L71/ADSR1/README.md

ADSR1
=====

Eurorack digitally controlled ADSR envelope generator.

*** Deprecated (for now at least). 
It works more or less as intended on a breadboard but it got replaced by the ADSR2 module which does more or less the same things but with no MCU.
