L71/ADSR1/PCB/ADSR1.brd

## EAGLE design PCB/ADSR1.brd (2015-07-12)

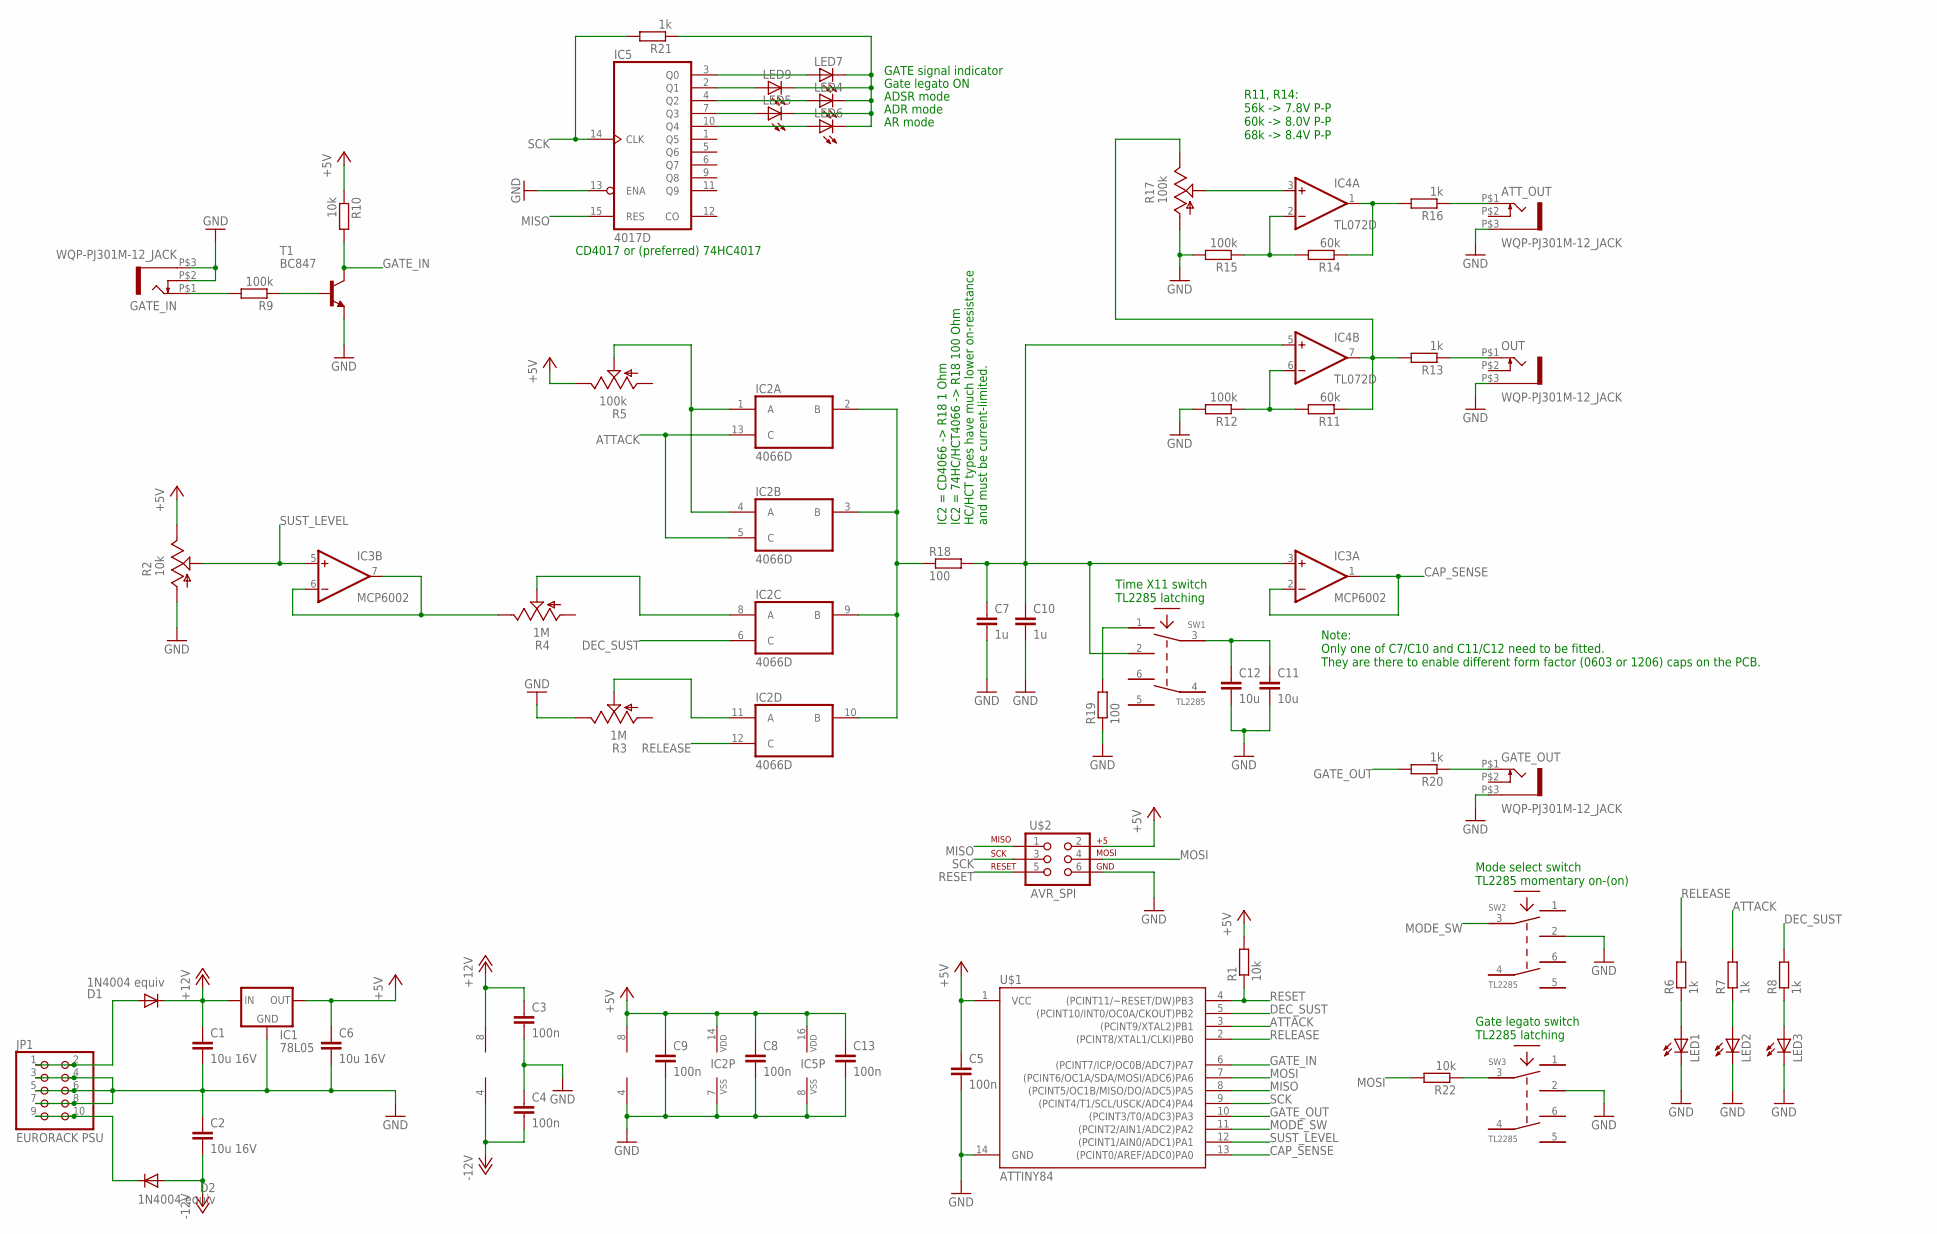
[picture p1: schematic ADSR1.sch]

Parts:
ATT_OUT: WQP-PJ301M-12_JACK
C1, C2, C6: 10u 16V; C1206K
C3, C4, C5, C8, C9, C13: 100n; C0603K
C7: 1u; C0603K
C10: 1u; C1206K
C11: 10u; C1206K
C12: 10u; C0603K
D1, D2: 1N4004 equiv; DO214AA
GATE_IN: WQP-PJ301M-12_JACK
GATE_OUT: WQP-PJ301M-12_JACK
IC1: 78L05; SOT89R
IC2: 4066D; SO14
IC3: MCP6002; SO08
IC4: TL072D; SO08
IC5: 4017D; SO16
JP1: EURORACK PSU; 2X05
LED1, LED2, LED3, LED4, LED5, LED6, LED7, LED9: LED3MM
OUT: WQP-PJ301M-12_JACK
R1, R10, R22: 10k; R0603
R2: 10k; ALPS_POT_VERTICAL
R3, R4: 1M; ALPS_POT_VERTICAL
R5, R17: 100k; ALPS_POT_VERTICAL
R6, R7, R8, R13, R16, R20, R21: 1k; R0603
R9, R12, R15: 100k; R0603
R11, R14: 60k; R0603
R18, R19: 100; R1206
SW1, SW2, SW3: TL2285; TL2285_PCB
T1: BC847; SOT23
U$1: ATTINY84; SO14
U$2: AVR_SPI; 2X3

Connections:
+5V: C5.1, C6.1, C8.1, C9.1, C13.1, IC1.PAD1 (OUT), IC2.14 (VDD), IC3.8 (V+), IC5.16 (VDD), R1.2, R2.P$1 (E), R5.P$1 (E), R10.1, U$1.1 (VCC), U$2.2
+12V: C1.1, C3.1, D1.C, IC1.PAD3 (IN), IC4.8 (V+)
-12V: C2.2, C4.2, D2.A, IC4.4 (V-)
ATTACK: IC2.5 (C), IC2.13 (C), R7.2, U$1.3 ((PCINT9/XTAL2)PB1)
CAP_SENSE: IC3.1 (OUT), IC3.2 (-IN), U$1.13 ((PCINT0/AREF/ADC0)PA0)
DEC_SUST: IC2.6 (C), R8.2, U$1.5 ((PCINT10/INT0/OC0A/CKOUT)PB2)
GATE_IN: R10.2, T1.3 (C), U$1.6 ((PCINT7/ICP/OC0B/ADC7)PA7)
GATE_OUT: R20.2, U$1.10 ((PCINT3/T0/ADC3)PA3)
GND: ATT_OUT.P$3 (1), C1.2, C2.1, C3.2, C4.1, C5.2, C6.2, C7.2, C8.2, C9.2, C10.2, C11.2, C12.2, C13.2, GATE_IN.P$2 (3), GATE_IN.P$3 (1), GATE_OUT.P$3 (1), IC1.PAD2 (GND), IC1.PAD4 (GND), IC2.7 (VSS), IC3.4 (V-), IC5.8 (VSS), IC5.13 (ENA), JP1.3, JP1.4, JP1.5, JP1.6, JP1.7, JP1.8, LED1.K (C), LED2.K (C), LED3.K (C), OUT.P$3 (1), R2.P$3 (A), R3.P$1 (E), R12.2, R15.2, R17.P$3 (A), R19.1, SW2.2, SW3.2, T1.2 (E), U$1.14 (GND), U$2.6
MISO: IC5.15 (RES), U$1.8 ((PCINT5/OC1B/MISO/DO/ADC5)PA5), U$2.1
MODE_SW: SW2.3, U$1.11 ((PCINT2/AIN1/ADC2)PA2)
MOSI: R22.2, U$1.7 ((PCINT6/OC1A/SDA/MOSI/ADC6)PA6), U$2.4
unnamed: C7.1, C10.1, IC3.3 (+IN), IC4.5 (+IN), R18.2, SW1.2
unnamed: GATE_IN.P$1 (2), R9.2
unnamed: D1.A, JP1.1, JP1.2
unnamed: LED3.A, R8.1
unnamed: IC2.11 (A), R3.P$2 (S)
unnamed: IC2.8 (A), R4.P$2 (S)
unnamed: IC3.6 (-IN), IC3.7 (OUT), R4.P$1 (E)
unnamed: LED2.A, R7.1
unnamed: LED1.A, R6.1
unnamed: IC2.1 (A), IC2.4 (A), R5.P$2 (S)
unnamed: OUT.P$1 (2), R13.1
unnamed: IC4.6 (-IN), R11.2, R12.1
unnamed: R9.1, T1.1 (B)
unnamed: D2.C, JP1.9, JP1.10
unnamed: IC4.7 (OUT), R11.1, R13.2, R17.P$1 (E)
unnamed: C11.1, C12.1, SW1.3
unnamed: IC2.2 (B), IC2.3 (B), IC2.9 (B), IC2.10 (B), R18.1
unnamed: R19.2, SW1.1
unnamed: ATT_OUT.P$1 (2), R16.1
unnamed: IC4.1 (OUT), R14.1, R16.2
unnamed: IC4.2 (-IN), R14.2, R15.1
unnamed: IC5.2 (Q1), LED9.A
unnamed: GATE_OUT.P$1 (2), R20.1
unnamed: IC4.3 (+IN), R17.P$2 (S)
unnamed: IC5.4 (Q2), LED4.A
unnamed: IC5.7 (Q3), LED5.A
unnamed: IC5.10 (Q4), LED6.A
unnamed: LED4.K (C), LED5.K (C), LED6.K (C), LED7.K (C), LED9.K (C), R21.1
unnamed: IC5.3 (Q0), LED7.A
unnamed: R22.1, SW3.3
RELEASE: IC2.12 (C), R6.2, U$1.2 ((PCINT8/XTAL1/CLKI)PB0)
RESET: R1.1, U$1.4 ((PCINT11/~RESET/DW)PB3), U$2.5
SCK: IC5.14 (CLK), R21.2, U$1.9 ((PCINT4/T1/SCL/USCK/ADC4)PA4), U$2.3
SUST_LEVEL: IC3.5 (+IN), R2.P$2 (S), U$1.12 ((PCINT1/AIN0/ADC1)PA1)

Notes on the sheet:
R11, R14: 56k -> 7.8V P-P 60k -> 8.0V P-P 68k -> 8.4V P-P
Time X11 switch TL2285 latching
IC2 = CD4066 -> R18 1 Ohm IC2 = 74HC/HCT4066 -> R18 100 Ohm HC/HCT types have much lower on-resistance and must be current-limited.
Note: Only one of C7/C10 and C11/C12 need to be fitted. They are there to enable different form factor (0603 or 1206) caps on the PCB.
Mode select switch TL2285 momentary on-(on)
GATE signal indicator
ADSR mode
ADR mode
AR mode
CD4017 or (preferred) 74HC4017
Gate legato switch TL2285 latching
Gate legato ON

Board: 2 copper layers, 61 parts (0 on the bottom side), 46 nets, no tracks yet.
