L71/ADSR1/env.c

// main application 

#include <avr/io.h>
#include <avr/interrupt.h>


// ADC latest values
struct adc_data {
	uint8_t cap_level, sust_level ;
} adc ;

// state machine tracking
#define RELEASING	1
#define ATTACKING	2
#define DEC_SUST	3

// gate event flags
uint8_t gate_went_high=0 ;	// event: gate went high
uint8_t gate_went_low=0 ;	// event: gate went low

// at which ADC/capacitor level the attack phase should be considered done
#define ATTACK_DONE_LVL  254	

// user interface LEDs bit register
uint8_t ui_led_bits=0b00000000;
#define GATE_LED 			0x01			// b0:	gate indicator
#define GATE_LEGATO_LED 	0x02			// b1:	gate legato on/off
#define ADSR_LED 			0x04			// b2:	ADSR mode
#define ADR_LED 			0x08			// b3:	ADR mode	(attack->decay to sustain level->release)
#define ASR_LED				0x10			// b4:	A(S)R mode 	(attack->sustain level->release)
#define NR_LED_BITS			5				// this number of LEDs 

// configure AD converter
void adc_setup() {
	// enable ADC, clock prescaler = /64
	ADCSRA |= (1<<ADEN) | (1<<ADPS2) | (1<<ADPS0) ;
	// left adjust result, we'll use 8 bits results in high byte only.
	ADCSRB |= (1<<ADLAR);
	// disable digital IO on used ADC pins
	DIDR0 = 0b00000011;	
	// Go! =)
	ADCSRA |= (1<<ADSC) ;
}

// start main timer
void run_main_timer() {	// enable 16bit timer1 + interrupts
	OCR1AH = 0x03; // 8MHz, divider 1000 -> 8KHz timer
	OCR1AL = 0xe8;
	// clear on OCR1A, clock prescaler 1. 
	TCCR1B |= (1<<WGM12) | (1<<CS10) ;
	// enable OCR1A interrupt
	TIMSK1 |= (1<<OCIE1A);
}

// functions to manage the 74HC4066 switches for the envelope stages
// only ONE of three must be enabled at once.
inline void sw_set_release() {
	PORTB &= 0xf8;	// all switches off
	PORTB |= _BV(PB0);	
}
inline void sw_set_attack() {
	PORTB &= 0xf8;	// all switches off
	PORTB |= _BV(PB1);
}
inline void sw_set_dec_sust() {
	PORTB &= 0xf8;	// all switches off
	PORTB |= _BV(PB2);
}


// GATE signal handling & interrupt
// 
// setup pin change interrupt
void pc_int_setup() {
	GIMSK |= _BV(PCIE0) ;	// enable pin change 0 interrupt 
	PCMSK0 |= _BV(PCINT7); // enable pin change interrupts for PA7.
}

// update IO and states when gate status changes
inline void set_gate_high() {
	gate_went_high = 1 ;
	ui_led_bits |= GATE_LED;
	PORTA |= _BV(PA3);
}

inline void set_gate_low() {
	gate_went_low = 1;
	ui_led_bits &= ~GATE_LED;
	PORTA &= ~_BV(PA3);
}

ISR(PCINT0_vect) {  	// GATE IN pin change interrupt

	uint8_t gate ; // gate input value
	gate = ( ~PINA & 0x80 );	// check gate input pin

	// clear gate change flags
	gate_went_high=0;
	gate_went_low=0;

	if (gate) {
		set_gate_high();
	} 
	if (! gate) {
		set_gate_low();
	}
	
}


// main envelope state machine
inline void state_update() {

	static uint8_t stage = RELEASING ; 	// curremt ENV stage
	
	// state machine 
	switch (stage) {
	
		case RELEASING:
			if (gate_went_high) {	// act on activated gate signal
				stage = ATTACKING;
				sw_set_attack();
			}
			break;
			
		case ATTACKING:
			// capacitor level reached limit? -> go to decay/sustain
			if (adc.cap_level >= ATTACK_DONE_LVL) {
				stage = DEC_SUST;
				sw_set_dec_sust();
			}
			// gate went low while attacking? -> go to release
			if (gate_went_low) {
				stage = RELEASING;
				sw_set_release();
			}
			break;
			
		case DEC_SUST:
			// gate went low in decay/sustain? -> go to release
			if (gate_went_low) {
				stage = RELEASING;
				sw_set_release();
			}
			if (gate_went_high) {	// act on activated gate signal -> attack phase
				stage = ATTACKING;
				sw_set_attack();
			}
			break;
			
	}
	// clear gate change flags
	gate_went_high=0;
	gate_went_low=0;
}

// reset and update ui led driver/counter chip
void update_ui_leds() {
	// PA4/SCK:			clock out for UI counter ship
	// PA5/MISO:		reset out for UI counter chip
	static uint8_t seq=0;
	
	PORTA &= ~_BV(PA4);	// make sure CLK is low
	
	if (seq == 0) {	// start at 0: reset counter chip
		PORTA |= _BV(PA4);	// PA4 high, make sure LED is off from start
		PORTA |= _BV(PA5);	// send reset pulse... 
		PORTA &= ~_BV(PA5);	// ...
	}
	if (seq > 0) {
		PORTA |= _BV(PA4);	// if not on first bit, pulse counter, next LED
	}
	
	if ( ui_led_bits & (1<<seq)) {	// check if this LED bit is 1? 
		PORTA &= ~_BV(PA4);  		// if so, set PA4 low -> LED lights up
	} 
	seq++;
	if (seq == NR_LED_BITS) {	
		seq=0;
	}
	if (PINA & _BV(PA6)) {
		ui_led_bits |= 0x10;
	} else {
		ui_led_bits &= ~0x10;
	}
}


ISR(TIM1_COMPA_vect) {
	
	static uint8_t adc_chan=0;

	
	uint8_t chan_mask=0x01; // use 2 channels (0-1).
	uint8_t adc_in = ADCH;	// read 8 MSB of ACD results (8 bit resolution used)
	
	switch (adc_chan) {
		case 0 :	// chan 0, current envelope capapcitor level
			adc.cap_level = adc_in;
			break;
		case 1 :	// chan 1, currently set sustain level
			adc.sust_level = adc_in;
			break;

	}

	// next channel...
	adc_chan = ((adc_chan+1) & chan_mask ) ;
	
	// update ADMUX register
	ADMUX &= 0xf0;	// reset channel bits
	ADMUX |= adc_chan ;
	
	// update ENV state machine 
	state_update();
	
	update_ui_leds();
	
	// start next conversion
	ADCSRA |= (1<<ADSC) ;

}
