L71/ADSR1/(commit log)

2015-06-27 Use AVR pin change interrupt to handle the gate signals (PA7).
2015-06-27 Initial upload of board and schematics.
    [ENV1.brd, ENV1.sch]
2015-06-27 Value adjustments for timing capacitors. Added forgotten diode in -12V supply.
    [ENV1.brd, ENV1.sch]
2015-06-28 Added handling of 74HC4017 counter chip that manages the UI LEDs. Added same chip to schematic.
    [ENV1.brd, ENV1.sch]
2015-07-12 More or less working breadboard prototype. Will probably not do more with this in a while (if ever).
    [ADSR1.brd, ADSR1.sch]
